MxMueller99/YAHA/assets/pcb/Yaha.kicad_pcb

## KiCad design assets/pcb/Yaha.kicad_pcb (2025-05-23)

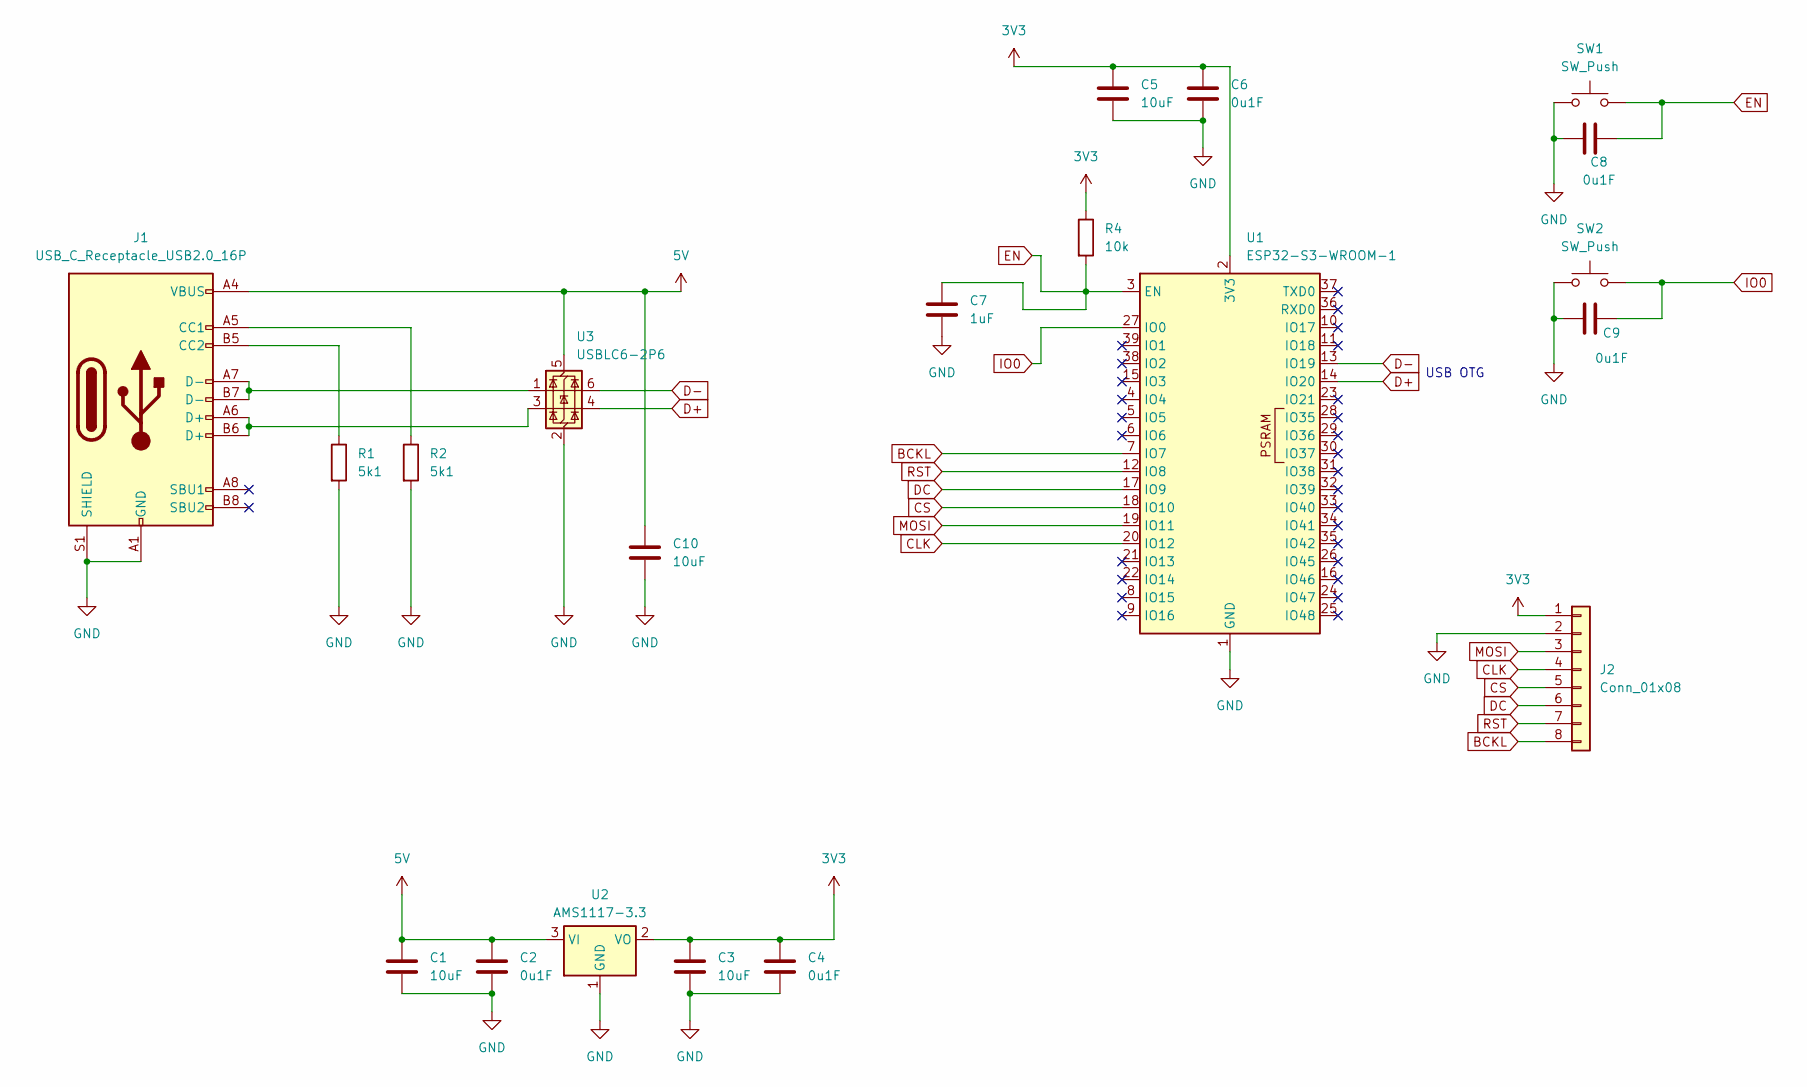
[picture p4: schematic Yaha.kicad_sch]

Parts:
C1, C3, C5, C10: 10uF; C_0603_1608Metric
C2, C4, C6, C8, C9: 0u1F; C_0603_1608Metric
C7: 1uF; C_0603_1608Metric
J1: USB_C_Receptacle_USB2.0_16P; USB_C_Receptacle_GCT_USB4105-xx-A_16P_TopMnt_Horizontal
J2: Conn_01x08; Molex_LCD_conn
R1, R2: 5k1; R_0603_1608Metric
R4: 10k; R_0603_1608Metric
SW1, SW2: SW_Push; SW_SPST_PTS810
U1: ESP32-S3-WROOM-1
U2: AMS1117-3.3; SOT-223-3_TabPin2
U3: USBLC6-2P6; SOT-666

Connections:
3V3: C3.1, C4.1, C5.1, C6.1, J2.1, R4.1, U1.2 (3V3), U2.2 (VO)
5V: C1.1, C2.1, C10.1, J1.A4 (VBUS), J1.A9 (VBUS), J1.B4 (VBUS), J1.B9 (VBUS), U2.3 (VI), U3.5 (VBUS)
BCKL: J2.8, U1.7 (IO7)
CLK: J2.4, U1.20 (IO12)
CS: J2.5, U1.18 (IO10)
D+: U1.14 (IO20), U3.4 (I/O2)
D-: U1.13 (IO19), U3.6 (I/O1)
DC: J2.6, U1.17 (IO9)
EN: C7.1, C8.2, R4.2, SW1.2, U1.3 (EN)
GND: C1.2, C2.2, C3.2, C4.2, C5.2, C6.2, C7.2, C8.1, C9.1, C10.2, J1.A1 (GND), J1.A12 (GND), J1.B1 (GND), J1.B12 (GND), J1.S1 (SHIELD), J2.2, R1.2, R2.2, SW1.1, SW2.1, U1.1 (GND), U1.40 (GND), U1.41 (GND), U2.1 (GND), U3.2 (GND)
IO0: C9.2, SW2.2, U1.27 (IO0)
MOSI: J2.3, U1.19 (IO11)
unnamed: J1.A5 (CC1), R2.1
unnamed: J1.B5 (CC2), R1.1
unnamed: J1.A6 (D+), J1.B6 (D+), U3.3 (I/O2)
unnamed: J1.A7 (D-), J1.B7 (D-), U3.1 (I/O1)
RST: J2.7, U1.12 (IO8)

Notes on the sheet:
USB OTG

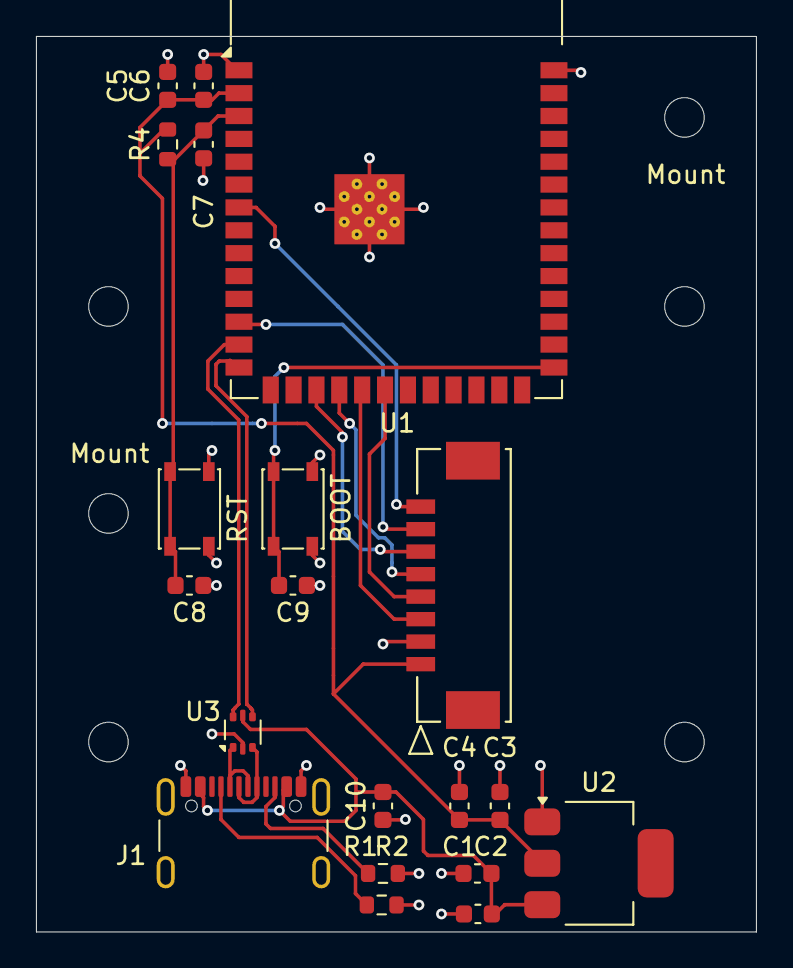
[picture p5: board Yaha.kicad_pcb from above]

Board: 2 copper layers, 40.0 x 49.8 mm, 20 parts (0 on the bottom side), 17 nets.
