MxMueller99/YAHA/(commit log)

2024-03-10 Added ISR for screen switching
2024-03-10 Screen switching via button implemented
2025-05-23 Polished YAHA
    [Yaha.kicad_pcb, Yaha.kicad_sch]
